dron0gus/rusefi-hardware/lambda-x2-module/JDY-33.STEP

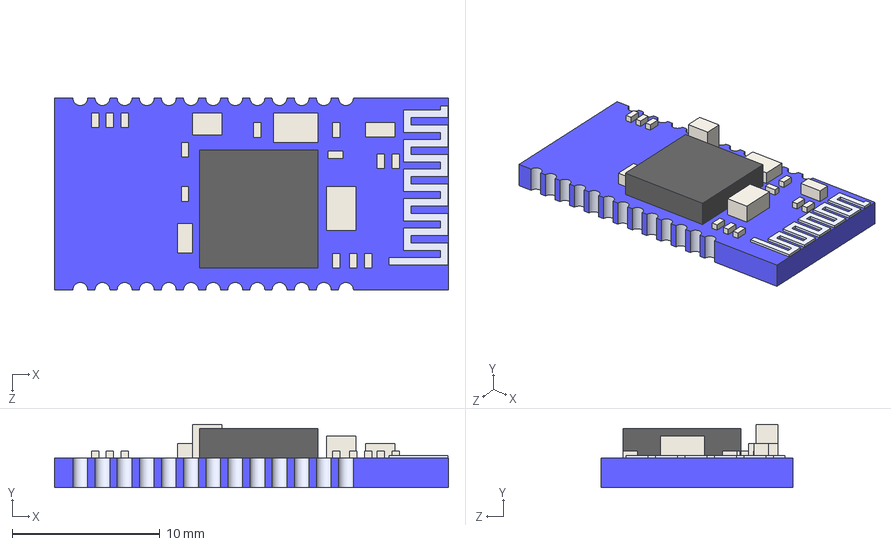
[picture p1: CAD file, 2022-12-02]
lambda-x2-module/JDY-33.STEP
26.7 x 4.30 x 13.0 mm
