dron0gus/rusefi-hardware/lambda-x2-module/33311-24AW-2.STEP

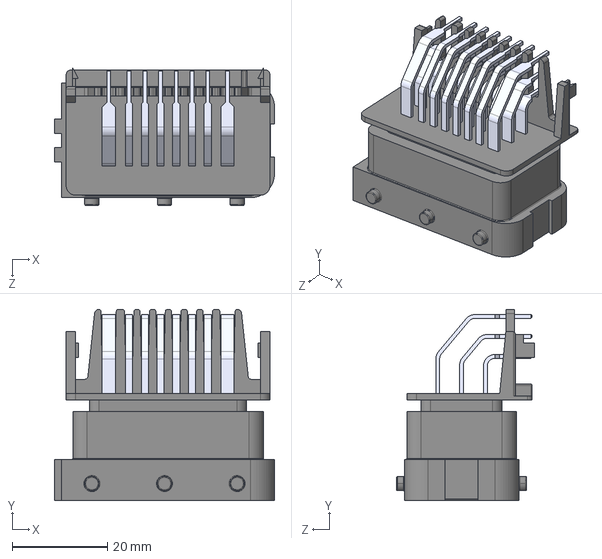
[picture p2: CAD file, 2022-12-02]
lambda-x2-module/33311-24AW-2.STEP
46.2 x 40.2 x 29.0 mm
