dron0gus/rusefi-hardware/lambda-x2-module/lambda-x2-module.kicad_pcb

## KiCad design lambda-x2-module/lambda-x2-module.kicad_pcb (2022-12-02)

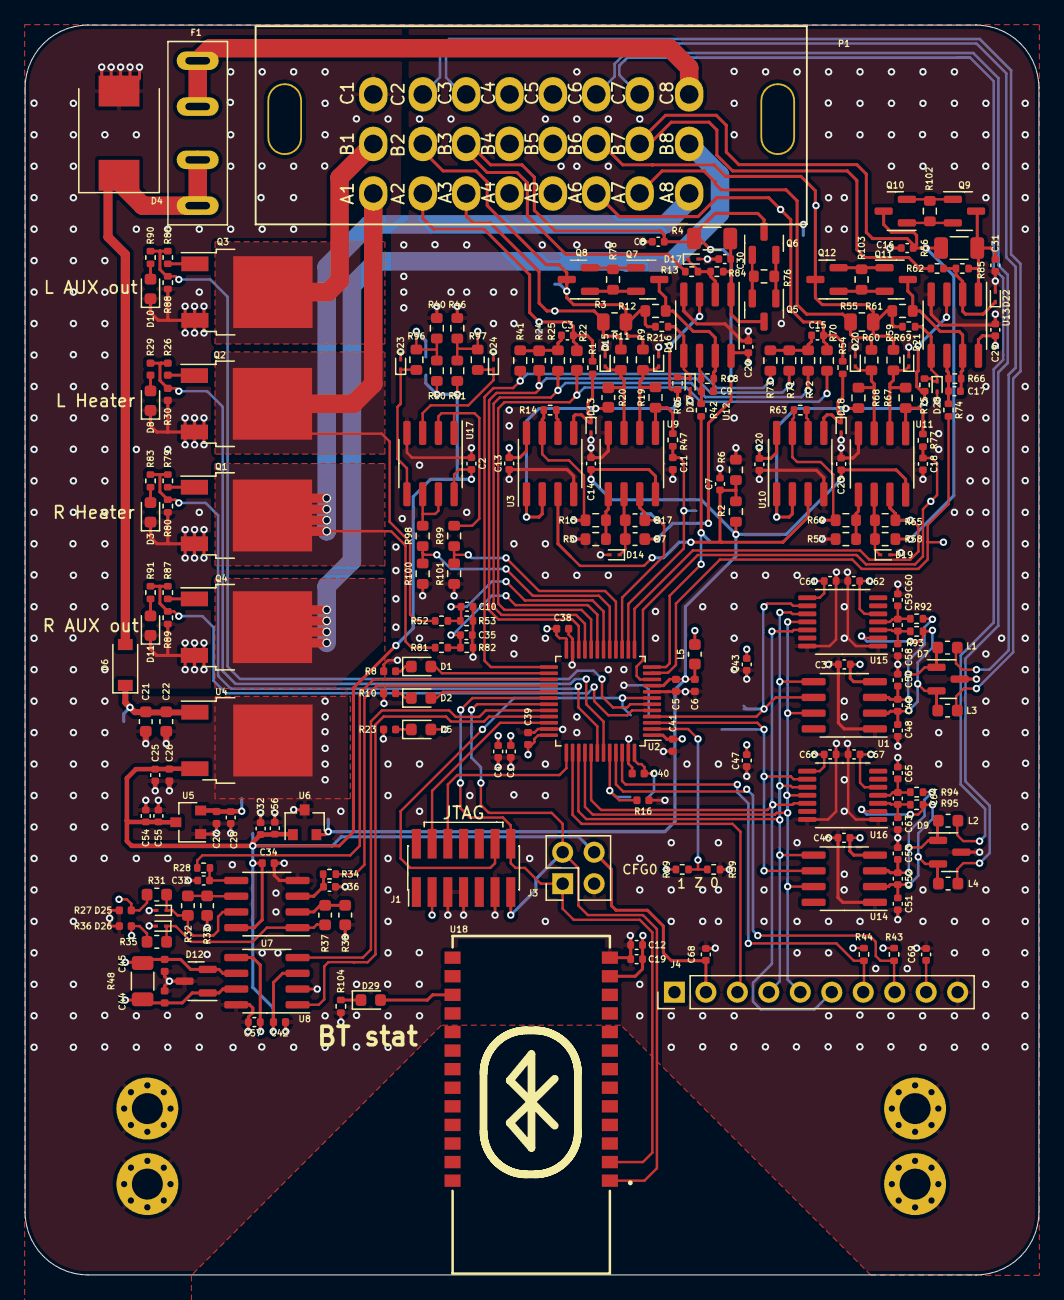
[picture p3: board lambda-x2-module.kicad_pcb from above]

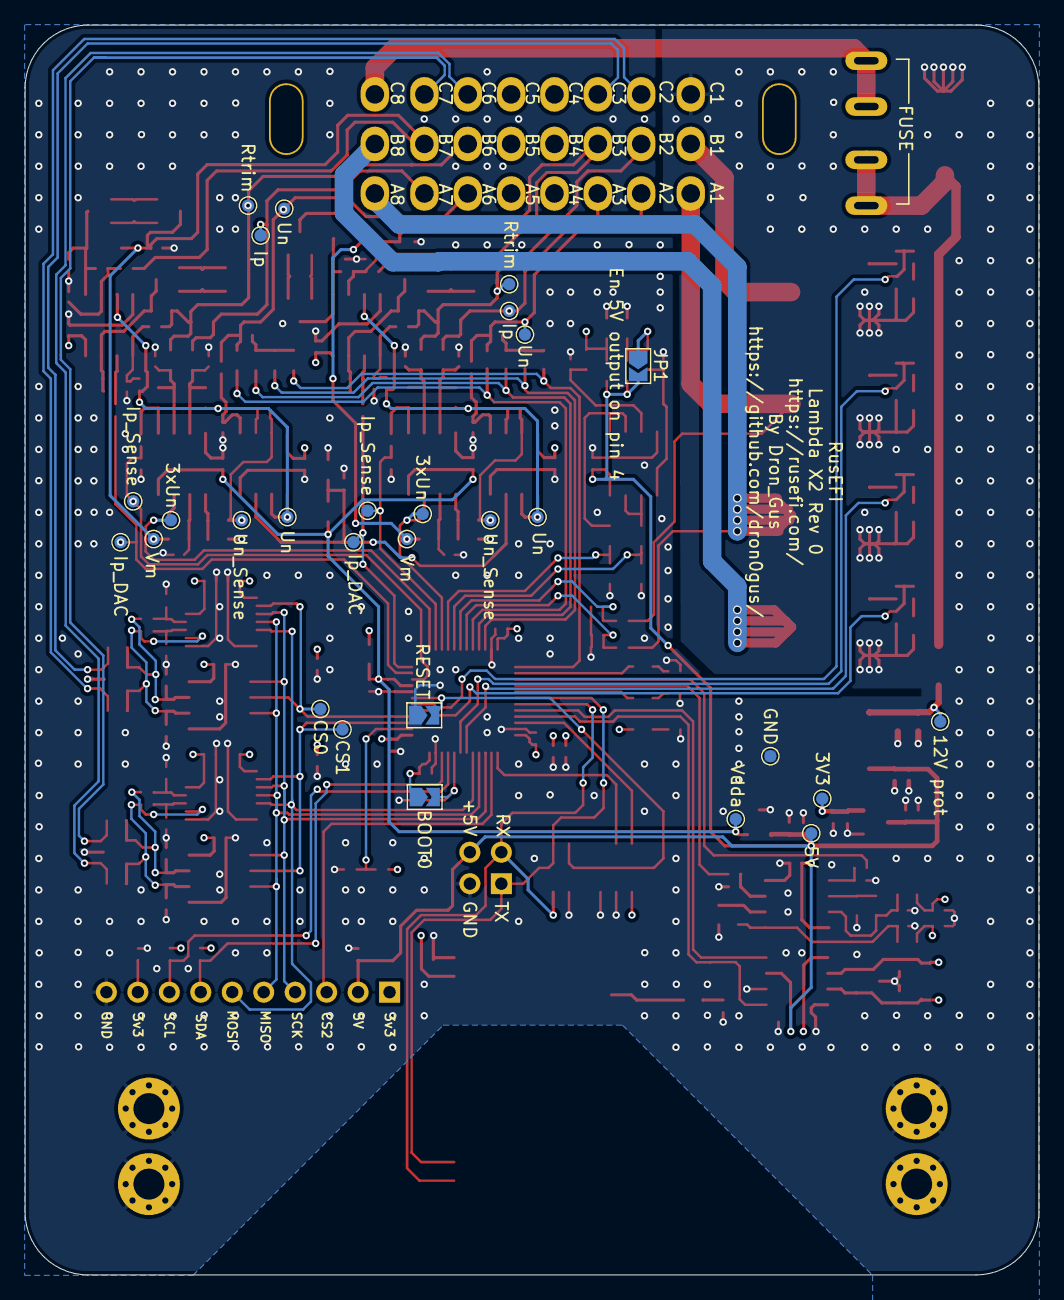
[picture p4: board lambda-x2-module.kicad_pcb from below]

Board: 4 copper layers, 81.8 x 100.9 mm, 274 parts (28 on the bottom side), 138 nets.

Parts:
C1, C6, C7, C8, C12, C16, C25, C28, C30, C31, C32, C43, C47, C54: 1u; C_0402_1005Metric
C2, C3, C5, C10, C11, C13, C14, C15, C18, C19, C20, C23, C24, C26, C27, C29, C34, C35, C37, C38, C39, C40, C41, C42, C46, C49, C52, C55, C56, C57, C59, C61, C62, C64, C66, C67, C68, C69: 100n; C_0402_1005Metric
C4: 4.7u; C_0402_1005Metric
C9, C17: 33n; C_0402_1005Metric
C21: 1u 25V; C_0603_1608Metric
C22: 100n 25V; C_0603_1608Metric
C33, C36: 2.2u; C_0402_1005Metric
C44, C45: 47p; C_0402_1005Metric
C48, C50, C51, C53, C58, C60, C63, C65: 10nF 50V; C_0402_1005Metric
D1: BLUE; LED_0603_1608Metric
D2, D29: GREEN; LED_0603_1608Metric
D3, D8, D10, D11: RED; LED_0603_1608Metric
D4: SMCJ22CA; D_SMC
D5: WHITE; LED_0603_1608Metric
D6: 1N4148W; D_SOD-123
D7, D9, D12: NUP2105L; SOT-23
D13, D14, D15, D16, D17, D18, D19, D20, D21, D22, D23, D24, D25, D26, D27, D28: ESD5V0D9B; D_SOD-923
F1: XF-506P
H1, H2, H3, H4: MountingHole_Pad; MountingHole_2.5mm_Pad_Via
J1: FTSH-107-01-F-DV-K; PinHeader_2x07_P1.27mm_Vertical_SMD
J3: Conn_02x02_Odd_Even; PinHeader_2x02_P2.54mm_Vertical
J4: Conn_01x10; PinHeader_1x10_P2.54mm_Vertical
JP1, JP2, JP3: SolderJumper_2_Open; SolderJumper-2_P1.3mm_Open_TrianglePad1.0x1.5mm
L1, L2, L3, L4, L5: 470R@100MHz; L_0603_1608Metric
P1: 33311-24AW-2
Q1, Q2, Q3, Q4: BTS3028; TO-252-2
Q5, Q6, Q7, Q8, Q9, Q10, Q11, Q12: BSS169H6327; SOT-23
R1, R14, R16, R18, R21, R27, R30, R36, R49, R54, R63, R66, R69, R80, R88, R89: 10k; R_0402_1005Metric
R2, R6, R7, R9, R11, R15, R58, R59, R60, R64, R96, R97: 10k 0.1%; R_0603_1608Metric
R3, R55: 61.9R 1%; R_0805_2012Metric
R4, R56: 10R; R_1206_3216Metric
R5, R17, R57, R65: 30k 1%; R_0603_1608Metric
R8, R10, R23, R26, R29, R79, R83, R86, R87, R90, R91, R104: 1k; R_0402_1005Metric
R12, R61: 47R; R_0603_1608Metric
R13, R53, R62, R82, R84, R85: 10k 1%; R_0402_1005Metric
R19, R20, R67, R68: 100k 0.1%; R_0603_1608Metric
R22, R70: 62k 1%; R_0603_1608Metric
R24, R71: 22k 0.1%; R_0603_1608Metric
R25, R72: 47k 1%; R_0603_1608Metric
R28, R34, R43, R44, R47, R77: 3.3k; R_0402_1005Metric
R31, R35: 330R; R_0603_1608Metric
R32, R37, R98, R99: 82k; R_0603_1608Metric
R33, R38, R100, R101: 160k; R_0603_1608Metric
R39: 0R; R_0402_1005Metric
R40, R46, R50, R51: 1K; R_0603_1608Metric
R41, R73: 6.8k 0.1%; R_0603_1608Metric
R42, R45, R74, R75: 68k; R_0402_1005Metric
R48: 120R; R_1206_3216Metric
R52, R81: 100k 1%; R_0402_1005Metric
R76, R78, R102, R103: 75R; R_0603_1608Metric
R92, R93, R94, R95: 100R; R_0402_1005Metric
TP3, TP4: Un_Sense; TestPoint_Pad_D1.0mm
TP5, TP6: 3xUn; TestPoint_Pad_D1.0mm
TP7: 5V; TestPoint_Pad_D1.0mm
TP8: 3V3; TestPoint_Pad_D1.0mm
TP9: Vdda; TestPoint_Pad_D1.0mm
TP10, TP17: Ip; TestPoint_Pad_D1.0mm
TP11, TP18: Rtrim; TestPoint_Pad_D1.0mm
TP12, TP19: Vm; TestPoint_Pad_D1.0mm
TP13, TP14, TP20, TP21: Un; TestPoint_Pad_D1.0mm
TP15, TP22: Ip_DAC; TestPoint_Pad_D1.0mm
TP16, TP23: Ip_Sense; TestPoint_Pad_D1.0mm
TP24: GND; TestPoint_Pad_D1.0mm
TP25: CS0; TestPoint_Pad_D1.0mm
TP26: CS1; TestPoint_Pad_D1.0mm
TP27: 12V prot; TestPoint_Pad_D1.0mm
U1, U14: MAX31855KASA; SOIC-8_3.9x4.9mm_P1.27mm
U2: STM32F103C6Tx; LQFP-48_7x7mm_P0.5mm
U3, U7, U10, U12, U13, U17: MCP6002T-I/SN; SOIC-8_3.9x4.9mm_P1.27mm
U4: LM78M05_TO252; TO-252-2
U5: XC6206P332MR; SOT-23
U6: REF3033; SOT-23
U8: TJA1051T-3; SOIC-8_3.9x4.9mm_P1.27mm
U9, U11: GS8332-SR; SOIC-8_3.9x4.9mm_P1.27mm
U15, U16: MAX31856; TSSOP-14_4.4x5mm_P0.65mm
U18: JDY-33

Connections:
12V_PROT: D4.1 (A1), D6.2 (A), F1.1
12V_RAW: F1.2, P1.24 (C8)
+3V3: C1.1, C4.1, C12.1, C13.1, C19.1, C20.1, C24.1, C27.1, C28.1, C29.1, C37.1, C38.1, C39.1, C40.1, C41.1, C43.1, C46.1, C47.1, C57.1, C61.1, C62.1, C66.1, C67.1, C69.1, D5.2 (A), J1.3, J4.1, J4.9, JP3.1 (A), L5.2, R43.1, R44.1, R49.2, TP8.1, U1.4 (VCC), U2.1 (VBAT), U2.24 (VDD), U2.36 (VDD), U2.48 (VDD), U3.8 (V+), U5.2 (VO), U8.5 (VIO), U10.8 (V+), U12.8 (V+), U13.8 (V+), U14.4 (VCC), U15.5 (AVDD), U15.8 (DVDD), U16.5 (AVDD), U16.8 (DVDD), U18.12 (3V3)
+5V: C2.1, C25.1, C26.1, C32.1, C34.1, C42.1, C54.1, C55.1, C56.1, C68.1, J3.4, J4.2, JP1.2 (B), R50.1, R51.1, TP7.1, U4.3 (VO), U5.3 (VI), U6.1 (IN), U7.8 (V+), U8.3 (VCC), U17.8 (V+)
/Boot0: JP3.2 (B), R16.2, U2.44 (BOOT0)
/CAN_H: C44.2, D12.1 (K), P1.20 (C4), R48.1, U8.7 (CANH)
/CAN_L: C45.1, D12.2 (K), P1.21 (C5), R48.2, U8.6 (CANL)
/CAN_RX: U2.32 (PA11), U8.4 (RXD)
/CAN_TX: U2.33 (PA12), U8.1 (TXD)
/I2C1_SCL: J4.8, R43.2, U2.45 (PB8)
/I2C1_SDA: J4.7, R44.2, U2.46 (PB9)
/LED_BLUE: D1.2 (A), U2.26 (PB13)
/LED_GREEN: D2.2 (A), U2.29 (PA8)
/LSU analog left/Un_sense: R14.2, R15.2, TP3.1, U3.7
/LSU analog left/Vgnd_ref: C7.1, R2.2, R6.1, U3.3 (+), U10.3 (+)
/LSU analog right/Un_sense: R63.2, R64.2, TP4.1, U10.7
/L_AUX: JP1.1 (A), P1.4 (A4), R40.1, R50.2, R96.2
/L_AUX_ADC: R98.1, R100.2, U2.17 (PA7)
/L_EGT+: L1.1, P1.19 (C3)
/L_EGT-: L3.1, P1.18 (C2)
/L_Heater_sense: C10.1, R52.2, R53.2, U2.18 (PB0)
/L_Ip_dac: R42.1, TP15.1, U2.12 (PA2)
/L_Ip_sense: C11.1, R47.1, TP16.1, U2.14 (PA4)
/L_LSU_Heater-: P1.1 (A1), Q2.2 (D), R52.1
/L_LSU_Ip: P1.3 (A3), R3.2, R11.2, TP10.1
/L_LSU_Rtrim: P1.10 (B2), Q8.3 (D), R3.1, R9.2, R12.1, R21.1, TP11.1
/L_LSU_Un: C3.1, P1.2 (A2), R1.1, R22.2, TP13.1
/L_LSU_Vm: C8.1, P1.11 (B3), Q6.3 (D), R4.1, R7.2, R13.1, TP12.1
/L_OD: P1.9 (B1), Q3.2 (D)
/L_OUT_en: R86.2, R88.2, R90.2, U2.6 (PD1)
/L_Un_3x_sense: R17.2, TP5.1, U2.15 (PA5), U9.7
/L_heater_pwm: R26.2, R29.2, R30.2, U2.43 (PB7)
/Nernst_4.2_esr_drive: R41.2, R73.2, U2.25 (PB12)
/Nernst_4.9_bias: R22.1, R70.1, U2.20 (PB2)
/Nernst_4.9_esr_drive: R24.2, R71.2, U2.22 (PB11)
/Nernst_ADV_esr_drive: R25.2, R72.2, U2.21 (PB10)
/PWMout1: R28.1, U2.27 (PB14)
/PWMout2: R34.1, U2.28 (PB15)
/R_AUX: P1.5 (A5), R46.1, R51.2, R97.2
/R_AUX_ADC: R99.1, R101.2, U2.16 (PA6)
/R_EGT+: L2.1, P1.23 (C7)
/R_EGT-: L4.1, P1.22 (C6)
/R_Heater_sense: C35.1, R81.2, R82.2, U2.19 (PB1)
/R_Ip_dac: R74.1, TP22.1, U2.11 (PA1)
/R_Ip_sense: C18.1, R77.1, TP23.1, U2.10 (PA0)
/R_LSU_Heater-: P1.8 (A8), Q1.2 (D), R81.1
/R_LSU_Ip: P1.7 (A7), R55.2, R60.2, TP17.1
/R_LSU_Rtrim: P1.14 (B6), Q12.3 (D), R55.1, R59.2, R61.1, R69.1, TP18.1
/R_LSU_Un: C15.1, P1.6 (A6), R54.1, R70.2, TP20.1
/R_LSU_Vm: C16.1, P1.15 (B7), Q10.3 (D), R56.1, R58.2, R62.1, TP19.1
/R_OD: P1.16 (B8), Q4.2 (D)
/R_OUT_en: R87.2, R89.2, R91.2, U2.5 (PD0)
/R_Un_3x_sense: R65.2, TP6.1, U2.13 (PA3), U11.7
/R_heater_pwm: R79.2, R80.2, R83.2, U2.42 (PB6)
/SPI1_CS0: TP25.1, U1.6 (~CS), U2.4 (PC15), U15.9 (~CS)
/SPI1_CS1: TP26.1, U2.3 (PC14), U14.6 (~CS), U16.9 (~CS)
/SPI1_CS2: J4.3, U2.38 (PA15)
/SPI1_MISO: J4.5, U1.7 (SO), U2.40 (PB4), U14.7 (SO), U15.11 (SDO), U16.11 (SDO)
/SPI1_MOSI: J4.6, U2.41 (PB5), U15.12 (SDI), U16.12 (SDI)
/SPI1_SCK: J4.4, U1.5 (SCK), U2.39 (PB3), U14.5 (SCK), U15.10 (SCK), U16.10 (SCK)
/SWCLK: J1.6, U2.37 (PA14)
/SWDIO: J1.4, U2.34 (PA13)
/UART_RX: J1.13, J3.2, U2.31 (PA10), U18.1 (TXD)
/UART_TX: J1.14, J3.1, U2.30 (PA9), U18.2 (RXD)
/Vout1: P1.13 (B5), R27.1, R31.2
/Vout2: P1.12 (B4), R35.2, R36.2
/config0: R39.1, R49.1, U2.2 (PC13)
/nRESET: J1.12, JP2.2 (B), U2.7 (NRST)
GND: C1.2, C2.2, C4.2, C5.2, C6.2, C7.2, C8.2, C10.2, C11.2, C12.2, C13.2, C14.2, C16.2, C18.2, C19.2, C20.2, C21.2, C22.2, C23.2, C24.2, C25.2, C26.2, C27.2, C28.2, C29.2, C30.2, C31.2, C32.2, C33.2, C34.2, C35.2, C36.2, C37.2, C38.2, C39.2, C40.2, C41.2, C42.2, C43.2, C44.1, C45.2, C46.2, C47.2, C48.2, C50.2, C51.2, C53.2, C54.2, C55.2, C56.2, C57.2, C58.2, C60.2, C61.2, C62.2, C63.2, C65.2, C66.2, C67.2, C68.2, C69.2, D3.1 (K), D4.2 (A2), D7.3 (A), D8.1 (K), D9.3 (A), D10.1 (K), D11.1 (K), D12.3 (A), D13.2 (A2), D14.2 (A2), D15.2 (A2), D16.2 (A2), D17.2 (A2), D18.2 (A2), D19.2 (A2), D20.2 (A2), D21.2 (A2), D22.2 (A2), D23.2 (A2), D24.2 (A2), D25.2 (A2), D26.2 (A2), D27.2 (A2), D28.2 (A2), H1.1, H2.1, H3.1, H4.1, J1.5, J1.7, J1.11, J3.3, J4.10, JP2.1 (A), P1.17 (C1), Q1.3 (S), Q2.3 (S), Q3.3 (S), Q4.3 (S), R5.1, R6.2, R8.1, R10.1, R16.1, R23.1, R27.2, R30.1, R33.1, R36.1, R38.1, R39.2, R40.2, R46.2, R53.1, R57.1, R80.1, R82.1, R88.1, R89.1, R100.1, R101.1, R104.1, TP24.1, U1.1 (GND), U2.8 (VSSA), U2.23 (VSS), U2.35 (VSS), U2.47 (VSS), U3.4 (V-), U4.2 (GND), U5.1 (GND), U6.3 (GND), U7.4 (V-), U8.2 (GND), U8.8 (S), U9.4 (V-), U10.4 (V-), U11.4 (V-), U12.4 (V-), U13.4 (V-), U14.1 (GND), U15.1 (AGND), U15.14 (DGND), U16.1 (AGND), U16.14 (DGND), U17.4 (V-), U18.13 (GND)
unnamed: C3.2, R24.1, R25.1, R41.1
unnamed: C9.1, Q7.3 (D), R12.2, R18.1, U12.7
unnamed: C9.2, R18.2, R42.2, U12.6 (-)
unnamed: C15.2, R71.1, R72.1, R73.1
unnamed: C17.1, Q11.3 (D), R61.2, R66.1, U13.7
unnamed: C17.2, R66.2, R74.2, U13.6 (-)
unnamed: C21.1, C22.1, D6.1 (K), TP27.1, U4.1 (VI)
unnamed: C30.1, Q5.3 (D), R4.2, R84.1, U12.1
unnamed: C31.1, Q9.3 (D), R56.2, R85.1, U13.1
unnamed: C33.1, R28.2, U7.5 (+)
unnamed: C36.1, R34.2, U7.3 (+)
unnamed: C48.1, C49.1, D7.2 (K), L3.2, R93.1, U1.2 (T-), U15.2 (BIAS)
unnamed: C49.2, C50.1, D7.1 (K), L1.2, R92.1, U1.3 (T+)
unnamed: C51.1, C52.1, D9.2 (K), L4.2, R95.1, U14.2 (T-), U16.2 (BIAS)
unnamed: C52.2, C53.1, D9.1 (K), L2.2, R94.1, U14.3 (T+)
unnamed: C58.1, C59.1, R93.2, U15.3 (T-)
unnamed: C59.2, C60.1, R92.2, U15.4 (T+)
unnamed: C63.1, C64.1, R95.2, U16.3 (T-)
unnamed: C64.2, C65.1, R94.2, U16.4 (T+)
unnamed: D1.1 (K), R8.2
unnamed: D2.1 (K), R10.2
unnamed: D3.2 (A), R83.1
unnamed: D5.1 (K), R23.2
unnamed: D8.2 (A), R29.1
unnamed: D10.2 (A), R90.1
unnamed: D11.2 (A), R91.1
unnamed: D13.1 (A1), R1.2, U3.5 (+)
unnamed: D14.1 (A1), R7.1, R17.1, U9.6 (-)
unnamed: D15.1 (A1), R11.1, R20.1, U9.3 (+)
unnamed: D16.1 (A1), R9.1, R19.2, U9.2 (-)
unnamed: D17.1 (A1), R13.2, R84.2, U12.2 (-)
unnamed: D18.1 (A1), R54.2, U10.5 (+)
unnamed: D19.1 (A1), R58.1, R65.1, U11.6 (-)
unnamed: D20.1 (A1), R60.1, R68.1, U11.3 (+)
unnamed: D21.1 (A1), R59.1, R67.2, U11.2 (-)
unnamed: D22.1 (A1), R62.2, R85.2, U13.2 (-)
unnamed: D23.1 (A1), R96.1, U17.5 (+)
unnamed: D24.1 (A1), R97.1, U17.3 (+)
unnamed: D25.1 (A1), R31.1, R32.2, U7.7
unnamed: D26.1 (A1), R35.1, R37.2, U7.1
unnamed: D27.1 (A1), R21.2, R45.1, U12.5 (+)
unnamed: D28.1 (A1), R69.2, R75.1, U13.5 (+)
unnamed: D29.1 (K), R104.2
unnamed: D29.2 (A), U18.16 (ALED)
unnamed: Q1.1 (G), R79.1
unnamed: Q2.1 (G), R26.1
unnamed: Q3.1 (G), R86.1
unnamed: Q4.1 (G), R87.1
unnamed: Q5.1 (G), Q6.2 (S), R76.1
unnamed: Q5.2 (S), Q6.1 (G), R76.2
unnamed: Q7.1 (G), Q8.2 (S), R78.1
unnamed: Q7.2 (S), Q8.1 (G), R78.2
unnamed: Q9.2 (S), Q10.1 (G), R102.2
unnamed: Q9.1 (G), Q10.2 (S), R102.1
unnamed: Q11.1 (G), Q12.2 (S), R103.1
unnamed: Q11.2 (S), Q12.1 (G), R103.2
unnamed: R14.1, U3.6 (-)
unnamed: R5.2, R15.1, U9.5 (+)
unnamed: R19.1, R47.2, U9.1
unnamed: R20.2, R45.2, TP14.1, U3.1, U3.2 (-), U12.3 (+)
unnamed: R32.1, R33.2, U7.6 (-)
unnamed: R37.1, R38.2, U7.2 (-)
unnamed: R57.2, R64.1, U11.5 (+)
unnamed: R63.1, U10.6 (-)
unnamed: R67.1, R77.2, U11.1
unnamed: R68.2, R75.2, TP21.1, U10.1, U10.2 (-), U13.3 (+)
unnamed: R98.2, U17.6 (-), U17.7
unnamed: R99.2, U17.1, U17.2 (-)
VDDA: C5.1, C6.1, C14.1, C23.1, L5.1, R2.1, TP9.1, U2.9 (VDDA), U6.2 (OUT), U9.8 (V+), U11.8 (V+)
