dron0gus/rusefi-hardware/wideband-F103/wideband_controller.kicad_pcb

## KiCad design wideband-F103/wideband_controller.kicad_pcb (2022-04-11)

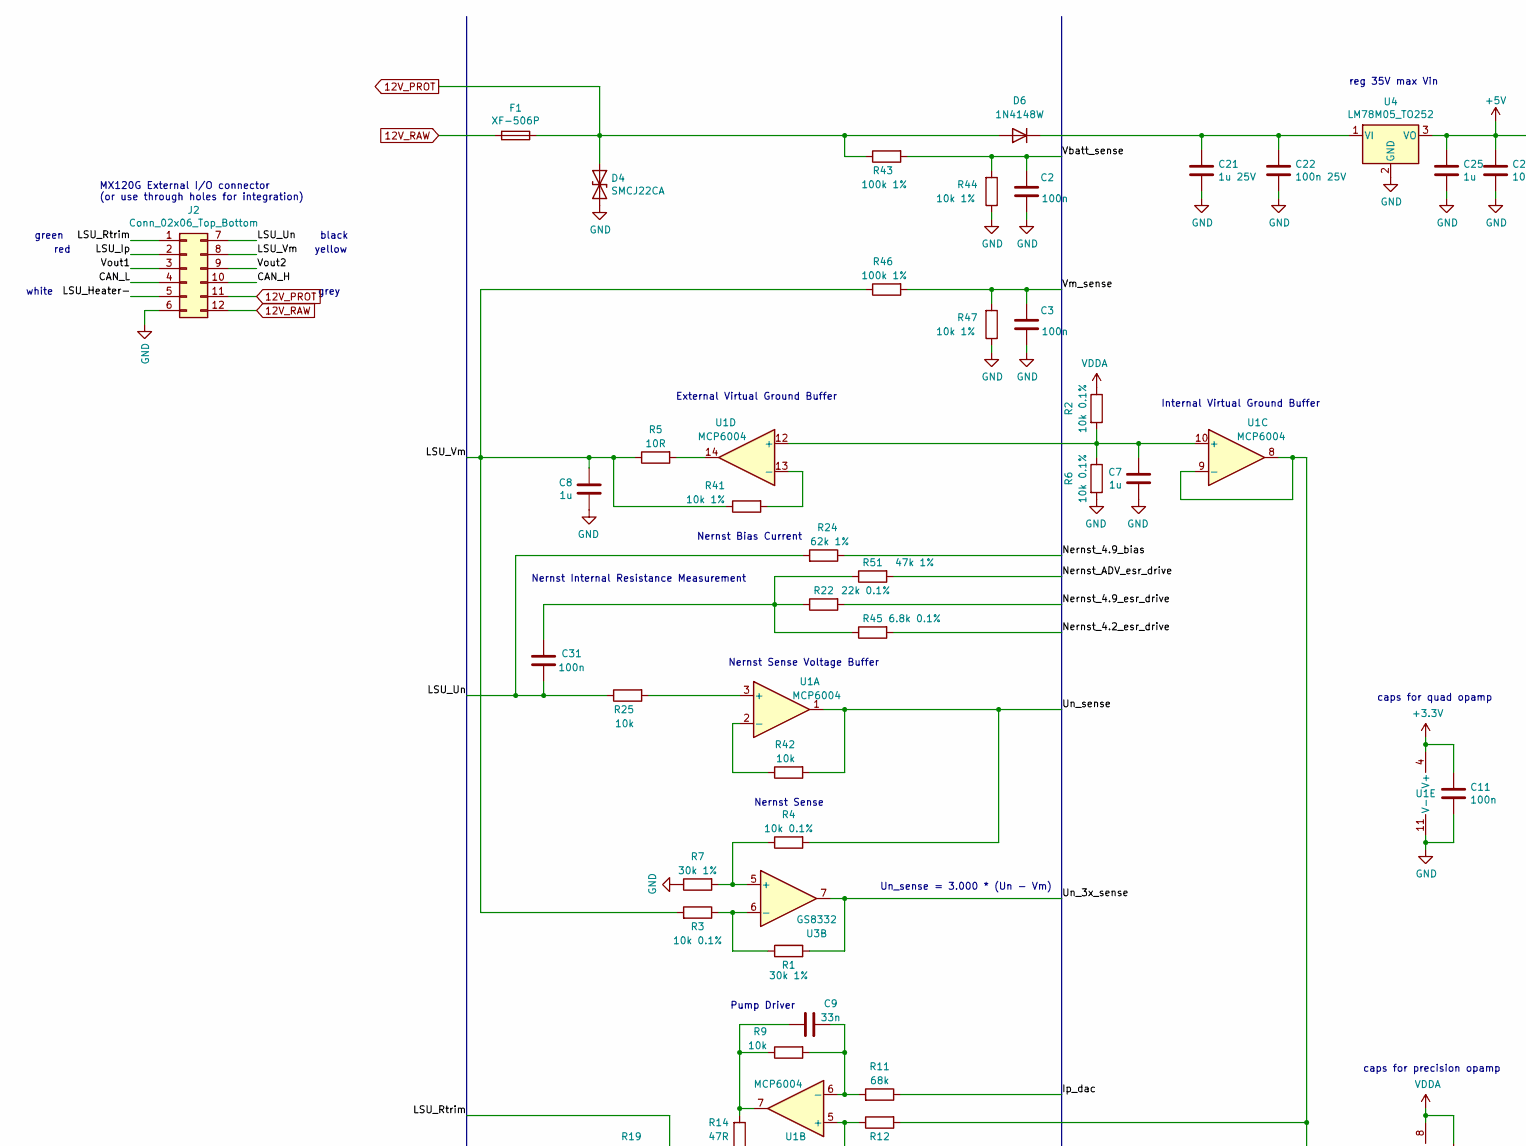
[picture p5: schematic wideband_controller.kicad_sch, part in row 1, column 1]

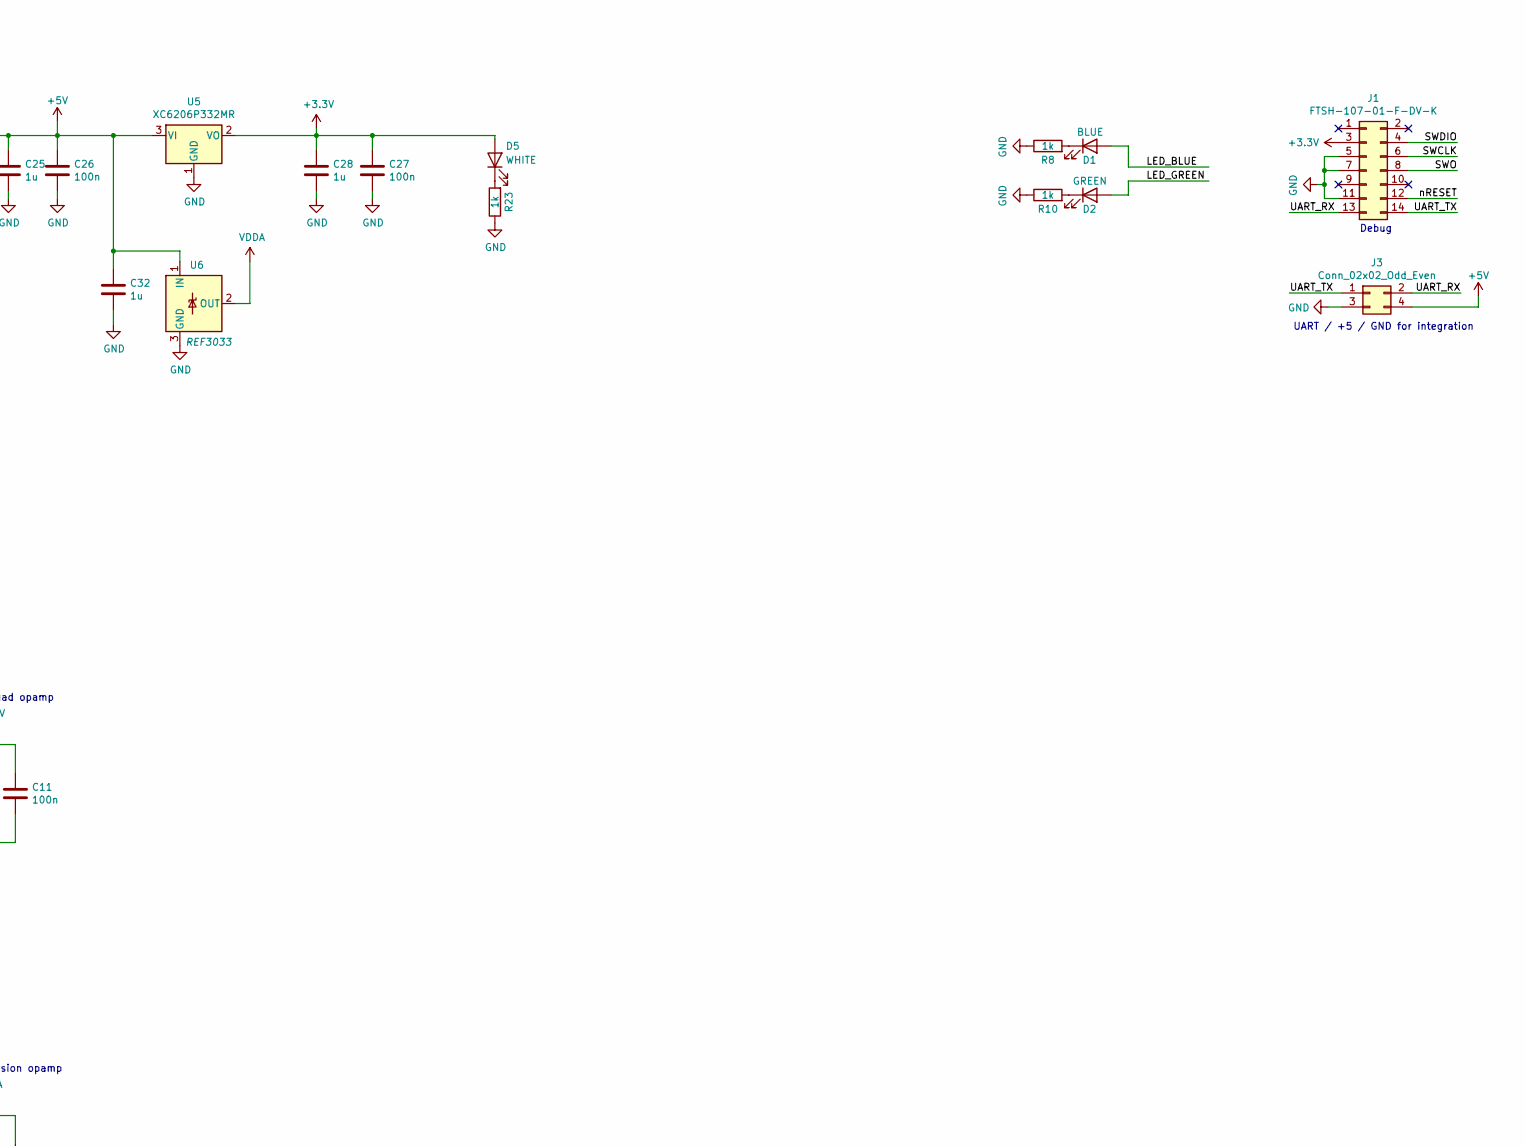
[picture p6: schematic wideband_controller.kicad_sch, part in row 1, column 2]

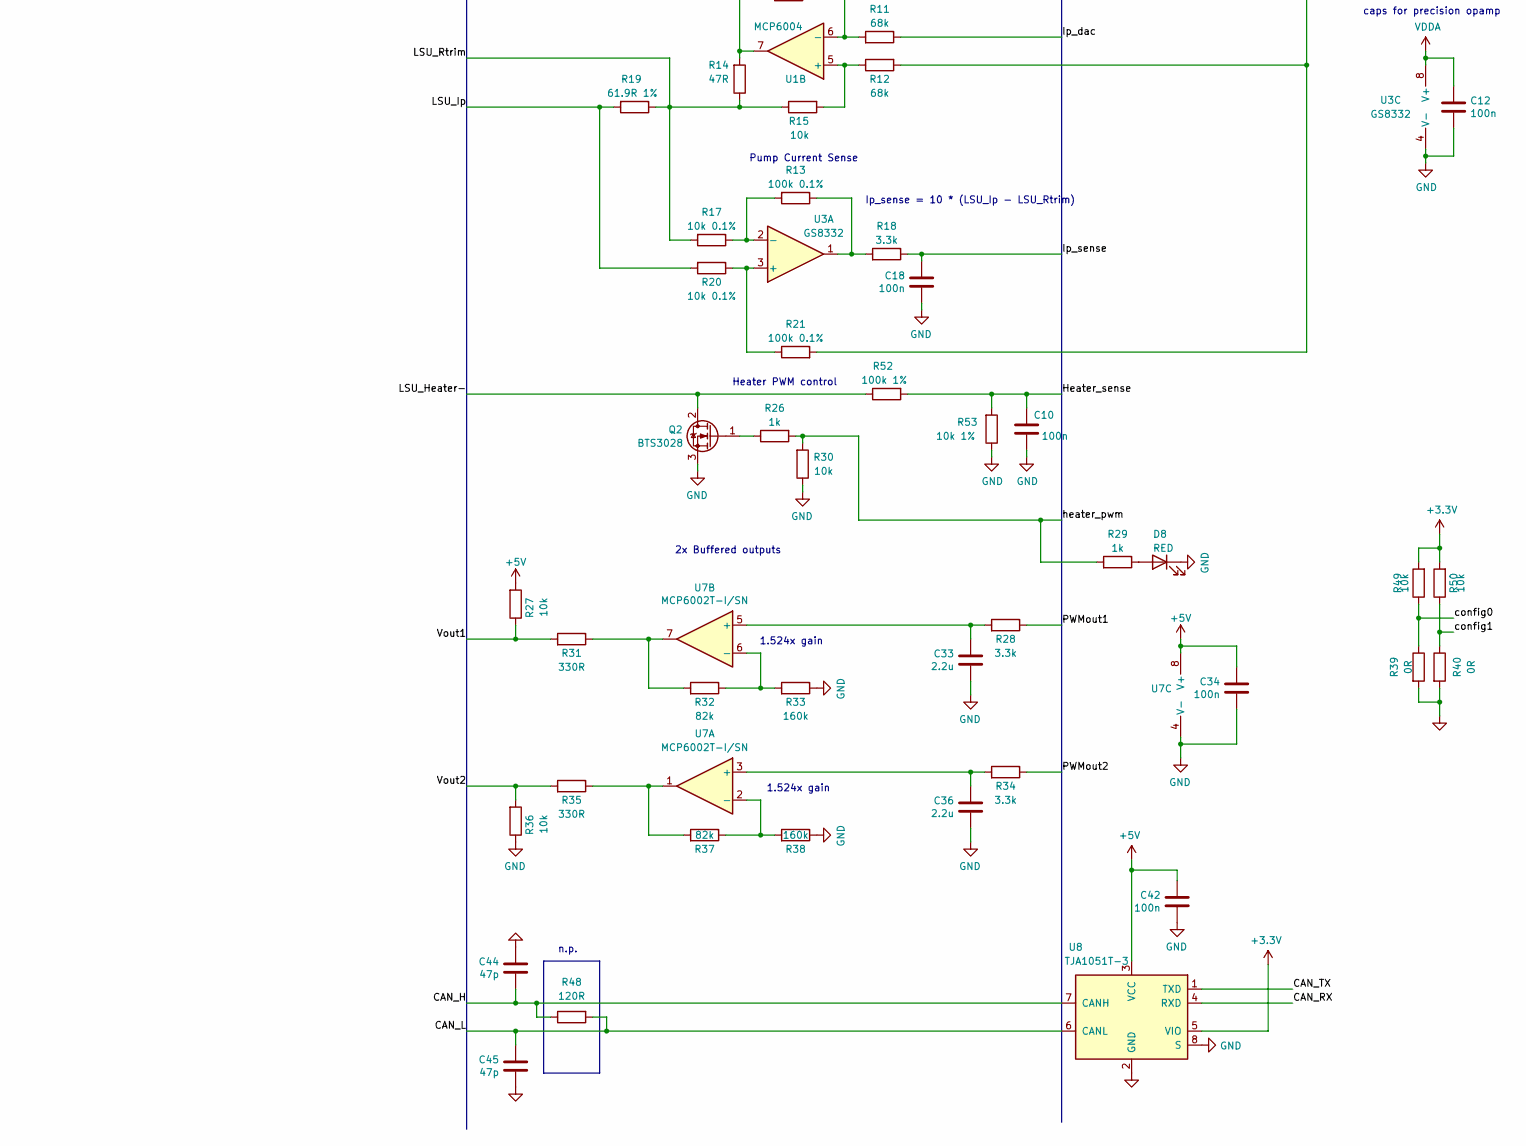
[picture p7: schematic wideband_controller.kicad_sch, part in row 2, column 1]

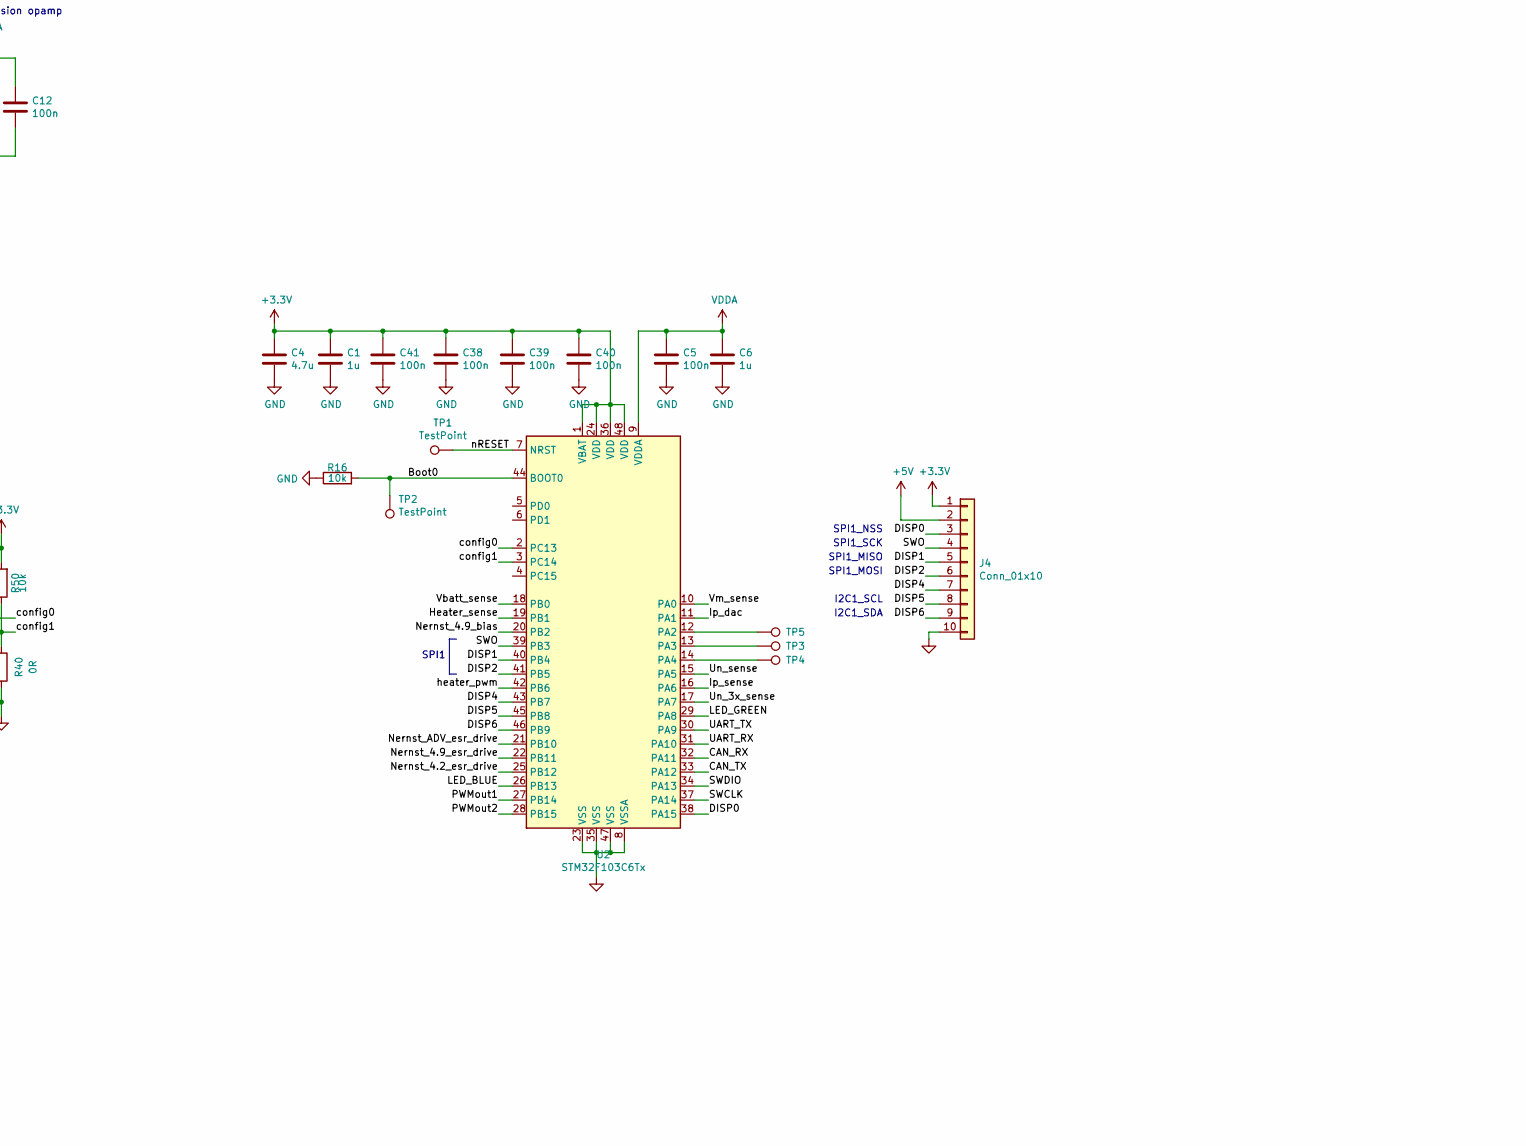
[picture p8: schematic wideband_controller.kicad_sch, part in row 2, column 2]

Parts:
C1, C6, C7, C8, C25, C28, C32: 1u; C_0402_1005Metric; LCSC C52923
C2, C3, C5, C10, C11, C12, C18, C26, C27, C31, C34, C38, C39, C40, C41, C42: 100n; C_0402_1005Metric; LCSC C1525
C4: 4.7u; C_0402_1005Metric; LCSC C23733
C9: 33n; C_0402_1005Metric; LCSC C1585
C21: 1u 25V; C_0603_1608Metric; LCSC C15849
C22: 100n 25V; C_0603_1608Metric; LCSC C14663
C33, C36: 2.2u; C_0402_1005Metric; LCSC C12530
C44, C45: 47p; C_0402_1005Metric; LCSC C1567
D1: BLUE; LED_0603_1608Metric; LCSC C72041
D2: GREEN; LED_0603_1608Metric; LCSC C72043
D4: SMCJ22CA; D_SMC; LCSC C310038
D5: WHITE; LED_0603_1608Metric; LCSC C2290
D6: 1N4148W; D_SOD-123; LCSC C81598
D8: RED; LED_0603_1608Metric; LCSC C2286
F1: XF-506P; LCSC C492610
J1: FTSH-107-01-F-DV-K; PinHeader_2x07_P1.27mm_Vertical_SMD
J2: Conn_02x06_Top_Bottom; MX120G_12
J3: Conn_02x02_Odd_Even; PinHeader_2x02_P2.54mm_Vertical
J4: Conn_01x10; PinHeader_1x10_P2.54mm_Vertical
Q2: BTS3028; TO-252-2; LCSC C112639
R1, R7: 30k 1%; R_0603_1608Metric; LCSC C22984
R2, R3, R4, R6, R17, R20: 10k 0.1%; R_0603_1608Metric; LCSC C309083
R5: 10R; R_1206_3216Metric; LCSC C17903
R8, R10, R23, R26, R29: 1k; R_0402_1005Metric; LCSC C11702
R9, R15, R16, R25, R27, R36, R42, R49, R50: 10k; R_0402_1005Metric; LCSC C25744
R11, R12: 68k; R_0402_1005Metric; LCSC C36871
R13, R21: 100k 0.1%; R_0603_1608Metric; LCSC C122538
R14: 47R; R_0603_1608Metric; LCSC C328363
R18, R28, R34: 3.3k; R_0402_1005Metric; LCSC C25890
R19: 61.9R 1%; R_0805_2012Metric; LCSC C322537
R22: 22k 0.1%; R_0603_1608Metric; LCSC C133163
R24: 62k 1%; R_0603_1608Metric; LCSC C23221
R30: 10k; R_0402_1005Metric; LCSC C11702
R31, R35: 330R; R_0603_1608Metric; LCSC C23138
R32, R37: 82k; R_0603_1608Metric; LCSC C23254
R33, R38: 160k; R_0603_1608Metric; LCSC C22813
R39, R40: 0R; R_0402_1005Metric; LCSC C325377
R41, R44, R47, R53: 10k 1%; R_0402_1005Metric; LCSC C25744
R43, R46, R52: 100k 1%; R_0402_1005Metric; LCSC C25741
R45: 6.8k 0.1%; R_0603_1608Metric; LCSC C705876
R48: 120R; R_1206_3216Metric; LCSC C176250
R51: 47k 1%; R_0603_1608Metric; LCSC C25819
TP1, TP2: TestPoint; PinHeader_1x01_P2.54mm_Vertical
TP3, TP4, TP5: TestPoint; TestPoint_Pad_D1.0mm
U1: MCP6004; TSSOP-14_4.4x5mm_P0.65mm; LCSC C50282
U2: STM32F103C6Tx; LQFP-48_7x7mm_P0.5mm
U3: GS8332; TSSOP-8_3x3mm_P0.65mm; LCSC C157714
U4: LM78M05_TO252; TO-252-2; LCSC C58069
U5: XC6206P332MR; SOT-23; LCSC C5446
U6: REF3033; SOT-23; LCSC C36658
U7: MCP6002T-I/SN; SO-8_3.9x4.9mm_P1.27mm; LCSC C7377
U8: TJA1051T-3; SOIC-8_3.9x4.9mm_P1.27mm; LCSC C38695

Connections:
12V_PROT: D4.1 (A1), D6.2 (A), F1.1, J2.11, R43.1
12V_RAW: F1.2, J2.12
+3V3: C1.1, C4.1, C11.1, C27.1, C28.1, C38.1, C39.1, C40.1, C41.1, D5.2 (A), J1.3, J4.1, R49.2, R50.2, U1.4 (V+), U2.1 (VBAT), U2.24 (VDD), U2.36 (VDD), U2.48 (VDD), U5.2 (VO), U8.5 (VIO)
+5V: C25.1, C26.1, C32.1, C34.1, C42.1, J3.4, J4.2, R27.2, U4.3 (VO), U5.3 (VI), U6.1 (IN), U7.8 (V+), U8.3 (VCC)
/Boot0: R16.2, TP2.1, U2.44 (BOOT0)
/CAN_H: C44.2, J2.10, R48.1, U8.7 (CANH)
/CAN_L: C45.1, J2.4, R48.2, U8.6 (CANL)
/CAN_RX: U2.32 (PA11), U8.4 (RXD)
/CAN_TX: U2.33 (PA12), U8.1 (TXD)
/DISP0: J4.3, U2.38 (PA15)
/DISP1: J4.5, U2.40 (PB4)
/DISP2: J4.6, U2.41 (PB5)
/DISP4: J4.7, U2.43 (PB7)
/DISP5: J4.8, U2.45 (PB8)
/DISP6: J4.9, U2.46 (PB9)
/Heater_sense: C10.1, R52.2, R53.2, U2.19 (PB1)
/Ip_dac: R11.1, U2.11 (PA1)
/Ip_sense: C18.1, R18.1, U2.16 (PA6)
/LED_BLUE: D1.2 (A), U2.26 (PB13)
/LED_GREEN: D2.2 (A), U2.29 (PA8)
/LSU_Heater-: J2.5, Q2.2 (D), R52.1
/LSU_Ip: J2.2, R19.2, R20.2
/LSU_Rtrim: J2.1, R14.1, R15.1, R17.2, R19.1
/LSU_Un: C31.1, J2.7, R24.2, R25.1
/LSU_Vm: C8.1, J2.8, R3.2, R5.1, R41.1, R46.1
/Nernst_4.2_esr_drive: R45.2, U2.25 (PB12)
/Nernst_4.9_bias: R24.1, U2.20 (PB2)
/Nernst_4.9_esr_drive: R22.2, U2.22 (PB11)
/Nernst_ADV_esr_drive: R51.2, U2.21 (PB10)
/PWMout1: R28.1, U2.27 (PB14)
/PWMout2: R34.1, U2.28 (PB15)
/SWCLK: J1.6, U2.37 (PA14)
/SWDIO: J1.4, U2.34 (PA13)
/SWO: J1.8, J4.4, U2.39 (PB3)
/UART_RX: J1.13, J3.2, U2.31 (PA10)
/UART_TX: J1.14, J3.1, U2.30 (PA9)
/Un_3x_sense: R1.2, U2.17 (PA7), U3.7
/Un_sense: R4.2, R42.2, U1.1, U2.15 (PA5)
/Vbatt_sense: C2.1, R43.2, R44.2, U2.18 (PB0)
/Vm_sense: C3.1, R46.2, R47.2, U2.10 (PA0)
/Vout1: J2.3, R27.1, R31.2
/Vout2: J2.9, R35.2, R36.2
/config0: R39.1, R49.1, U2.2 (PC13)
/config1: R40.1, R50.1, U2.3 (PC14)
/heater_pwm: R26.2, R29.2, R30.2, U2.42 (PB6)
/nRESET: J1.12, TP1.1, U2.7 (NRST)
GND: C1.2, C2.2, C3.2, C4.2, C5.2, C6.2, C7.2, C8.2, C10.2, C11.2, C12.2, C18.2, C21.2, C22.2, C25.2, C26.2, C27.2, C28.2, C32.2, C33.2, C34.2, C36.2, C38.2, C39.2, C40.2, C41.2, C42.2, C44.1, C45.2, D4.2 (A2), D8.1 (K), J1.5, J1.7, J1.11, J2.6, J3.3, J4.10, Q2.3 (S), R6.2, R7.1, R8.1, R10.1, R16.1, R23.1, R30.1, R33.1, R36.1, R38.1, R39.2, R40.2, R44.1, R47.1, R53.1, U1.11 (V-), U2.8 (VSSA), U2.23 (VSS), U2.35 (VSS), U2.47 (VSS), U3.4 (V-), U4.2 (GND), U5.1 (GND), U6.3 (GND), U7.4 (V-), U8.2 (GND), U8.8 (S)
unnamed: C7.1, R2.2, R6.1, U1.10 (+), U1.12 (+)
unnamed: C9.1, R9.1, R14.2, U1.7
unnamed: C9.2, R9.2, R11.2, U1.6 (-)
unnamed: C21.1, C22.1, D6.1 (K), U4.1 (VI)
unnamed: C31.2, R22.1, R45.1, R51.1
unnamed: C33.1, R28.2, U7.5 (+)
unnamed: C36.1, R34.2, U7.3 (+)
unnamed: D1.1 (K), R8.2
unnamed: D2.1 (K), R10.2
unnamed: D5.1 (K), R23.2
unnamed: D8.2 (A), R29.1
unnamed: Q2.1 (G), R26.1
unnamed: R1.1, R3.1, U3.6 (-)
unnamed: R4.1, R7.2, U3.5 (+)
unnamed: R5.2, U1.14
unnamed: R12.1, R15.2, U1.5 (+)
unnamed: R12.2, R21.2, U1.8, U1.9 (-)
unnamed: R13.1, R18.2, U3.1
unnamed: R13.2, R17.1, U3.2 (-)
unnamed: R20.1, R21.1, U3.3 (+)
unnamed: R25.2, U1.3 (+)
unnamed: R31.1, R32.2, U7.7
unnamed: R32.1, R33.2, U7.6 (-)
unnamed: R35.1, R37.2, U7.1
unnamed: R37.1, R38.2, U7.2 (-)
unnamed: R41.2, U1.13 (-)
unnamed: R42.1, U1.2 (-)
unnamed: TP3.1, U2.13 (PA3)
unnamed: TP4.1, U2.14 (PA4)
unnamed: TP5.1, U2.12 (PA2)
VDDA: C5.1, C6.1, C12.1, R2.1, U2.9 (VDDA), U3.8 (V+), U6.2 (OUT)

Notes on the sheet:
Nernst Internal Resistance Measurement
Pump Current Sense
MX120G External I/O connector (or use through holes for integration)
Ip_sense = 10 * (LSU_Ip - LSU_Rtrim)
reg 35V max Vin
SPI1_MOSI
Internal Virtual Ground Buffer
SPI1
1.524x gain
I2C1_SCL
External Virtual Ground Buffer
Pump Driver
grey
Nernst Sense
Un_sense = 3.000 * (Un - Vm)
black
Nernst Bias Current
green
Debug
n.p.
2x Buffered outputs
caps for precision opamp
red
SPI1_SCK
Nernst Sense Voltage Buffer
SPI1_NSS
yellow
caps for quad opamp
Heater PWM control
I2C1_SDA
UART / +5 / GND for integration
white
SPI1_MISO

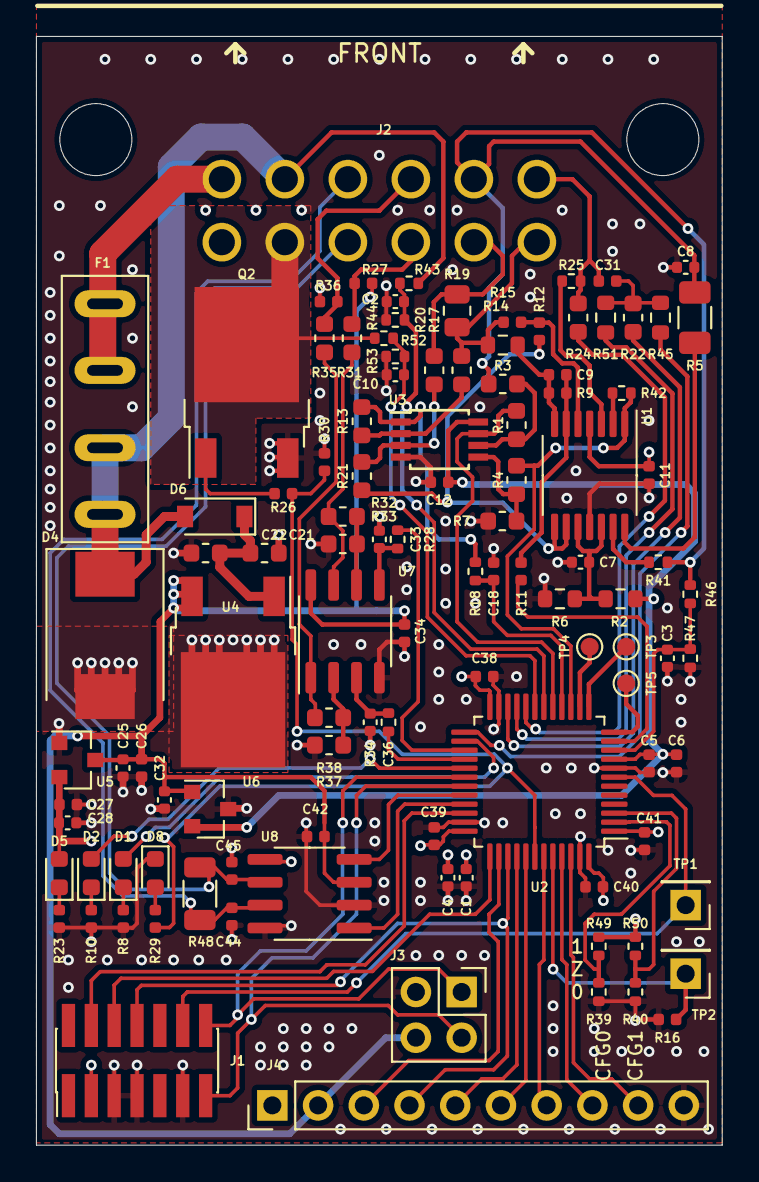
[picture p9: board wideband_controller.kicad_pcb from above]

Board: 4 copper layers, 38.1 x 61.6 mm, 109 parts (0 on the bottom side), 78 nets.
