dron0gus/rusefi-hardware/(commit log)

2022-04-11 Fix LCSC for few components
    [wideband_controller.kicad_pcb, wideband_controller.kicad_sch, wideband_controller_JLCBOM.csv]
2022-08-23 Decode Throtle position sensor 12639457AA
2022-12-02 lambda-x2-module: cleanup for making module
    [33311-24AW-2.STEP, JDY-33.STEP, egt.kicad_sch, lambda-x2-module.kicad_pcb, lambda-x2-module.kicad_sch, lsu.kicad_sch]
